htfab/breakout-tt08-cob/README.md

# Tiny Tapeout COB pcb (TT08)

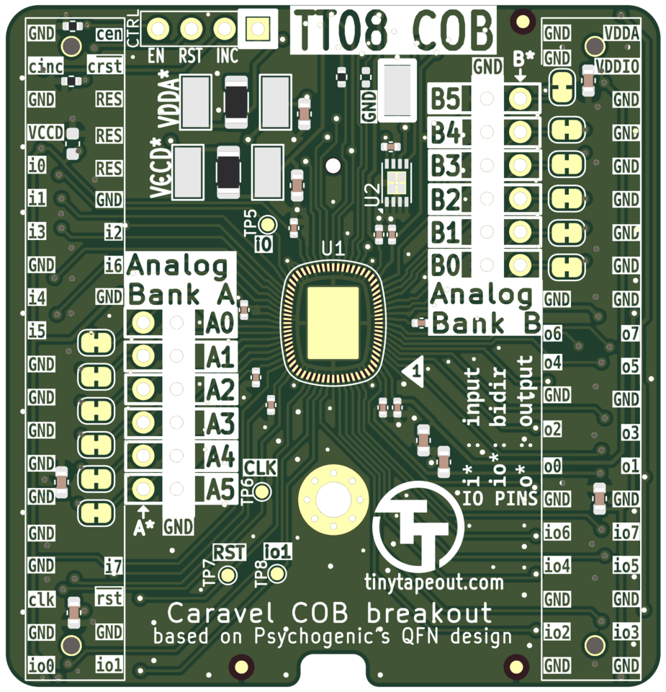
[picture p1: images/top.png]
&emsp;
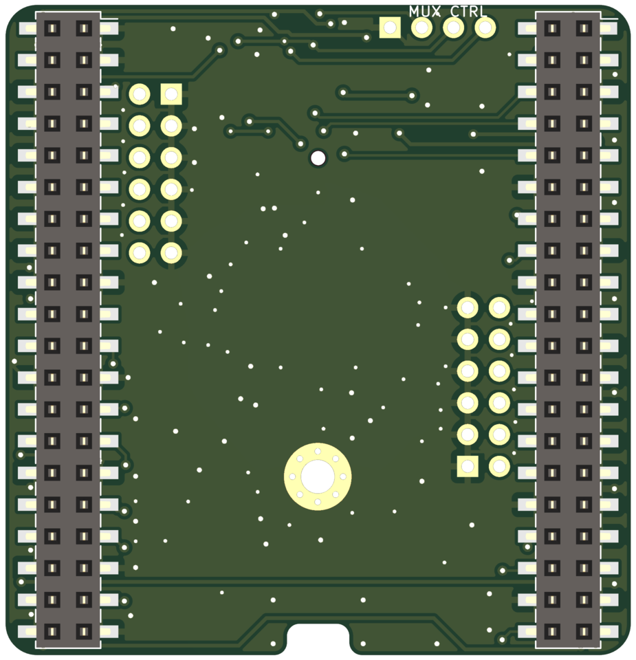
[picture p2: images/bottom.png]
