htfab/breakout-tt08-cob/breakout-tt08-cob.kicad_sch

## KiCad design breakout-tt08-cob.kicad_sch (2025-10-29)

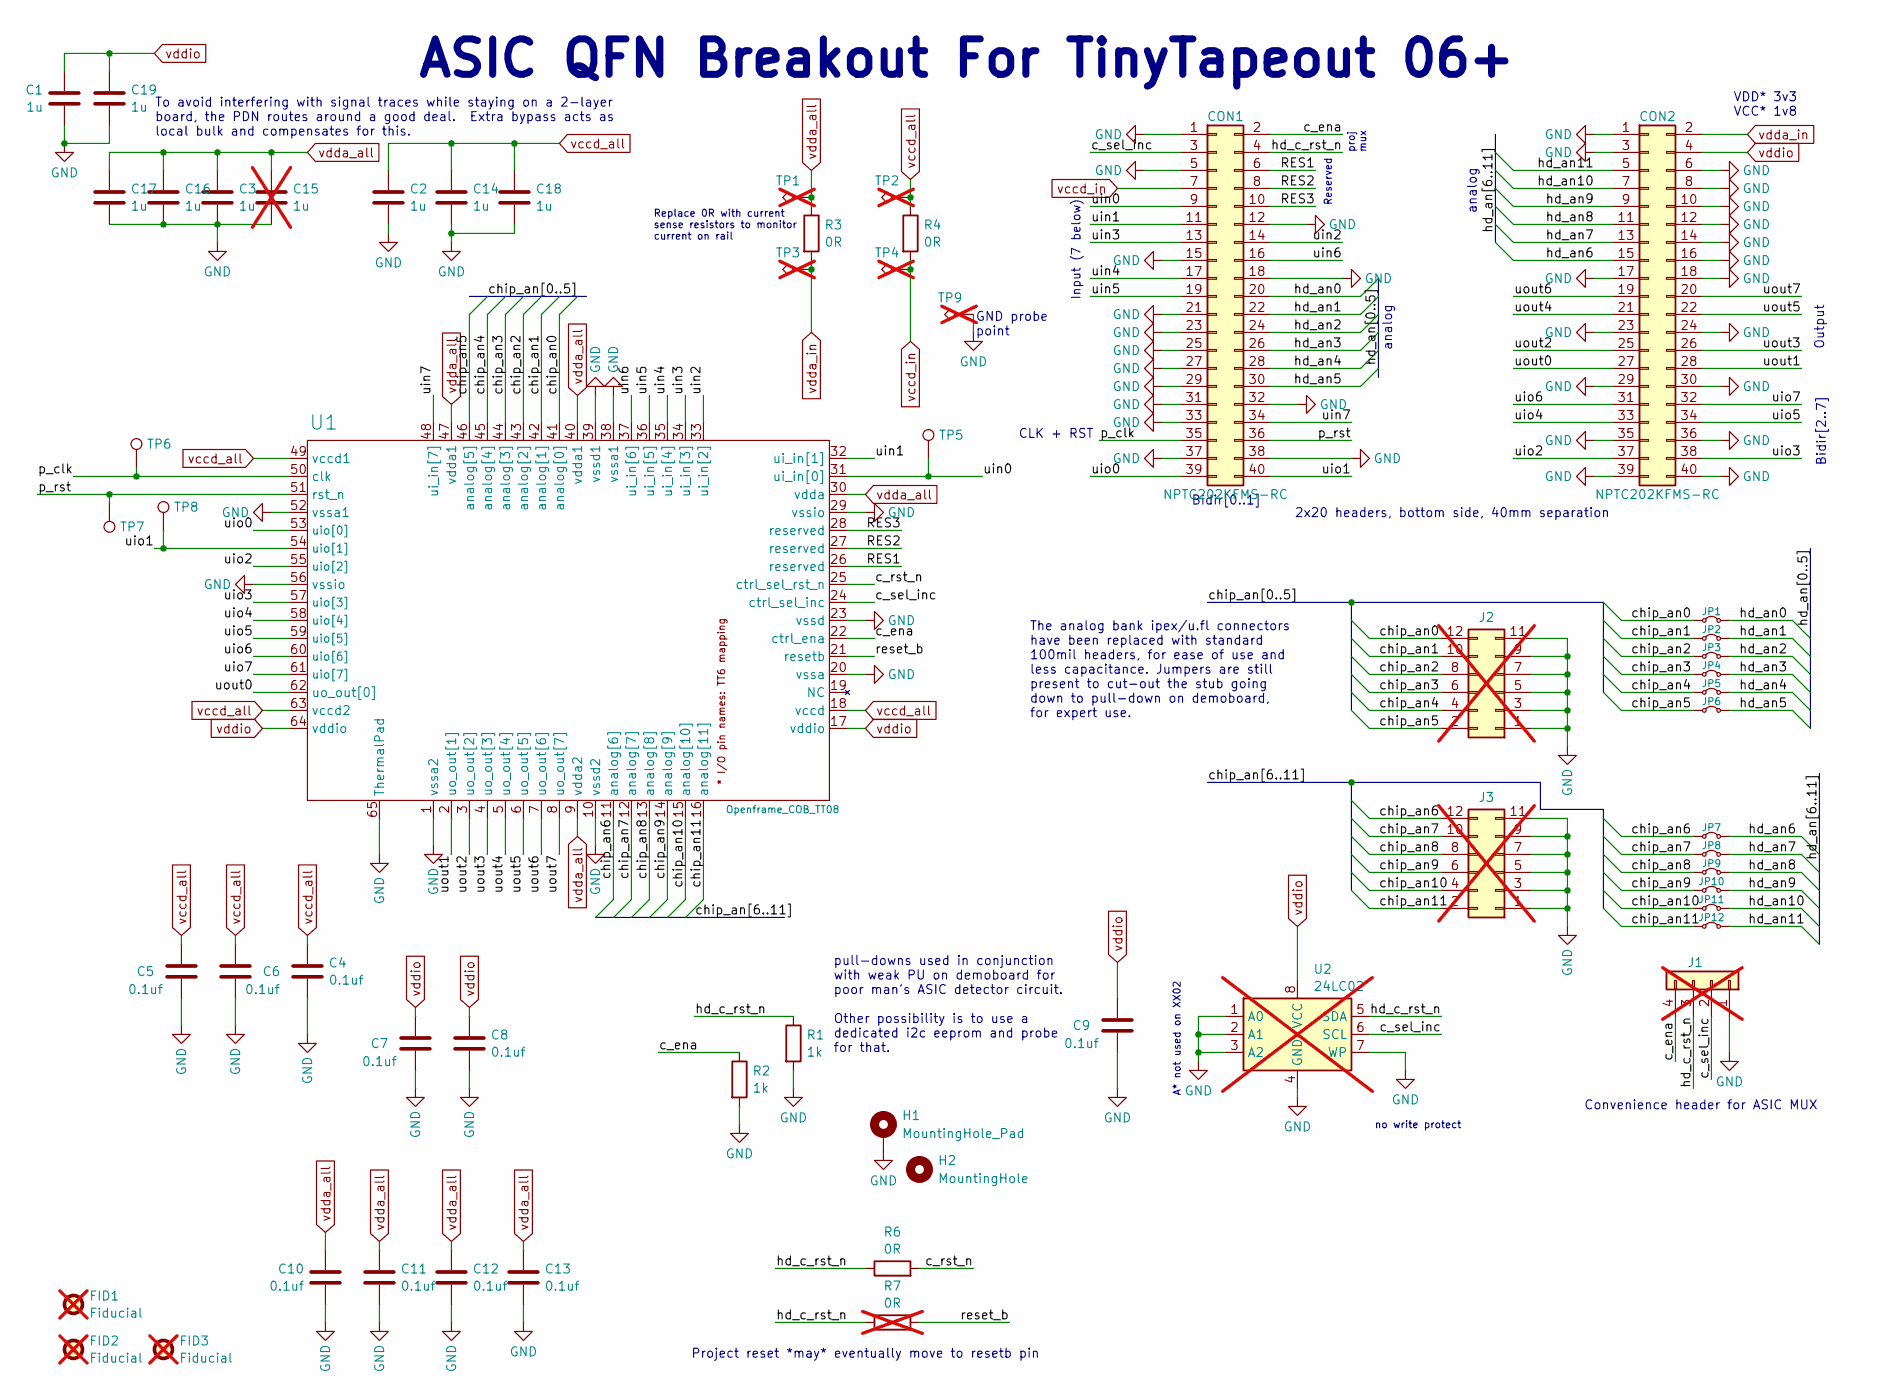
[picture p3: schematic breakout-tt08-cob.kicad_sch]

Parts:
C1, C2, C3, C14, C16, C17, C18, C19: C_1u_0603_50V; C_0603_1608Metric; MPN GRT188R61H105KE13D; DigikeyPN 490-12330-1-ND
C4, C5, C6, C7, C8, C9, C10, C11, C12, C13: 0.1uf; C_0402_1005Metric; MPN CL05A104KA5NNNC; LCSC C100072
C15: C_1u_0603_50V; C_0603_1608Metric; MPN GRT188R61H105KE13D; DigikeyPN 490-12330-1-ND; not fitted
CON1, CON2: NPTC202KFMS-RC; FH-00148_PinSocket_2x20_P2.54mm; MPN NPTC202KFMS-RC; DigikeyPN S5690-ND
FID1, FID2, FID3: Fiducial; Fiducial_1mm_Mask2mm; not fitted
H1: MountingHole_Pad; MountingHole_2.7mm_M2.5_Pad_Via
H2: MountingHole; ToolingHole_1.152mm
J1: Conn_01x04; PinHeader_1x04_P2.54mm_Vertical; not fitted
J2, J3: Conn_02x06_Odd_Even; PinHeader_2x06_P2.54mm_Vertical; not fitted
JP1, JP2, JP3, JP4, JP5, JP6, JP7, JP8, JP9, JP10, JP11, JP12: Jumper_2_Small_Bridged; SolderJumper-2_P1.3mm_Bridged_RoundedPad1.0x1.5mmEasyCut
R1, R2: 1k; R_0402_1005Metric; LCSC C202394
R3, R4: 0R; R_1206_3216Metric; MPN RC1206FR-130RL; DigikeyPN 13-RC1206FR-130RLCT-ND
R6: 0R; R_0402_1005Metric; MPN RC0402JR-070RL; DigikeyPN 311-0.0JRCT-ND
R7: 0R; R_0402_1005Metric; MPN RC0402JR-070RL; DigikeyPN 311-0.0JRCT-ND; not fitted
TP1, TP2, TP3, TP4, TP9: TestPoint_Alt; TestPoint_Keystone_5019_Minature; MPN 5019; DigikeyPN 36-5019CT-ND; not fitted
TP5, TP6, TP7, TP8: TestPoint; TestPoint_Pad_D1.0mm
U1: Openframe_COB_TT08; caravel_cob_100_105; MPN TT_ASIC
U2: 24LC02; DFN-8-1EP_3x2mm_P0.5mm_EP1.75x1.45mm; MPN 24LC02BT-I/MC; DigikeyPN 24LC02BT-I/MCCT-ND; not fitted

Connections:
GND: C1.2, C2.2, C3.2, C4.1, C5.1, C6.2, C7.1, C8.1, C9.1, C10.2, C11.2, C12.2, C13.1, C14.2, C15.2, C16.2, C17.2, C18.2, C19.2, CON1.1, CON1.5, CON1.12, CON1.15, CON1.18, CON1.21, CON1.23, CON1.25, CON1.27, CON1.29, CON1.31, CON1.32, CON1.33, CON1.37, CON1.38, CON2.1, CON2.3, CON2.6, CON2.8, CON2.10, CON2.12, CON2.14, CON2.16, CON2.17, CON2.18, CON2.23, CON2.24, CON2.29, CON2.30, CON2.35, CON2.36, CON2.39, CON2.40, H1.1, J1.1, J2.1, J2.3, J2.5, J2.7, J2.9, J2.11, J3.1, J3.3, J3.5, J3.7, J3.9, J3.11, R1.2, R2.2, TP9.1, U1.1 (vssa2), U1.10 (vssd2), U1.20 (vssa), U1.23 (vssd), U1.29 (vssio), U1.38 (vssa1), U1.39 (vssd1), U1.52 (vssa1), U1.56 (vssio), U1.65 (ThermalPad), U2.1 (A0), U2.2 (A1), U2.3 (A2), U2.4 (GND), U2.7 (WP)
RES1: CON1.6, U1.26 (reserved)
RES2: CON1.8, U1.27 (reserved)
RES3: CON1.10, U1.28 (reserved)
c_ena: CON1.2, J1.4, R2.1, U1.22 (ctrl_ena)
c_rst_n: R6.2, U1.25 (ctrl_sel_rst_n)
c_sel_inc: CON1.3, J1.2, U1.24 (ctrl_sel_inc), U2.6 (SCL)
chip_an0: J2.12, JP1.1 (A), U1.41 (analog[0])
chip_an1: J2.10, JP2.1 (A), U1.42 (analog[1])
chip_an2: J2.8, JP3.1 (A), U1.43 (analog[2])
chip_an3: J2.6, JP4.1 (A), U1.44 (analog[3])
chip_an4: J2.4, JP5.1 (A), U1.45 (analog[4])
chip_an5: J2.2, JP6.1 (A), U1.46 (analog[5])
chip_an6: J3.12, JP7.1 (A), U1.11 (analog[6])
chip_an7: J3.10, JP8.1 (A), U1.12 (analog[7])
chip_an8: J3.8, JP9.1 (A), U1.13 (analog[8])
chip_an9: J3.6, JP10.1 (A), U1.14 (analog[9])
chip_an10: J3.4, JP11.1 (A), U1.15 (analog[10])
chip_an11: J3.2, JP12.1 (A), U1.16 (analog[11])
hd_an0: CON1.20, JP1.2 (B)
hd_an1: CON1.22, JP2.2 (B)
hd_an2: CON1.24, JP3.2 (B)
hd_an3: CON1.26, JP4.2 (B)
hd_an4: CON1.28, JP5.2 (B)
hd_an5: CON1.30, JP6.2 (B)
hd_an6: CON2.15, JP7.2 (B)
hd_an7: CON2.13, JP8.2 (B)
hd_an8: CON2.11, JP9.2 (B)
hd_an9: CON2.9, JP10.2 (B)
hd_an10: CON2.7, JP11.2 (B)
hd_an11: CON2.5, JP12.2 (B)
hd_c_rst_n: CON1.4, J1.3, R1.1, R6.1, R7.1, U2.5 (SDA)
p_clk: CON1.35, TP6.1, U1.50 (clk)
p_rst: CON1.36, TP7.1, U1.51 (rst_n)
reset_b: R7.2, U1.21 (resetb)
uin0: CON1.9, TP5.1, U1.31 (ui_in[0])
uin1: CON1.11, U1.32 (ui_in[1])
uin2: CON1.14, U1.33 (ui_in[2])
uin3: CON1.13, U1.34 (ui_in[3])
uin4: CON1.17, U1.35 (ui_in[4])
uin5: CON1.19, U1.36 (ui_in[5])
uin6: CON1.16, U1.37 (ui_in[6])
uin7: CON1.34, U1.48 (ui_in[7])
uio0: CON1.39, U1.53 (uio[0])
uio1: CON1.40, TP8.1, U1.54 (uio[1])
uio2: CON2.37, U1.55 (uio[2])
uio3: CON2.38, U1.57 (uio[3])
uio4: CON2.33, U1.58 (uio[4])
uio5: CON2.34, U1.59 (uio[5])
uio6: CON2.31, U1.60 (uio[6])
uio7: CON2.32, U1.61 (uio[7])
uout0: CON2.27, U1.62 (uo_out[0])
uout1: CON2.28, U1.2 (uo_out[1])
uout2: CON2.25, U1.3 (uo_out[2])
uout3: CON2.26, U1.4 (uo_out[3])
uout4: CON2.21, U1.5 (uo_out[4])
uout5: CON2.22, U1.6 (uo_out[5])
uout6: CON2.19, U1.7 (uo_out[6])
uout7: CON2.20, U1.8 (uo_out[7])
vccd_all: C2.1, C4.2, C5.2, C6.1, C14.1, C18.1, R4.1, TP2.1, U1.18 (vccd), U1.49 (vccd1), U1.63 (vccd2)
vccd_in: CON1.7, R4.2, TP4.1
vdda_all: C3.1, C10.1, C11.1, C12.1, C13.2, C15.1, C16.1, C17.1, R3.1, TP1.1, U1.9 (vdda2), U1.30 (vdda), U1.40 (vdda1), U1.47 (vdda1)
vdda_in: CON2.2, R3.2, TP3.1
vddio: C1.1, C7.2, C8.2, C9.2, C19.1, CON2.4, U1.17 (vddio), U1.64 (vddio), U2.8 (VCC)

Notes on the sheet:
CLK + RST
Convenience header for ASIC MUX
Reserved
ASIC QFN Breakout For TinyTapeout 06+
VDD* 3v3 VCC* 1v8
A* not used on XX02
2x20 headers, bottom side, 40mm separation
no write protect
pull-downs used in conjunction with weak PU on demoboard for poor man's ASIC detector circuit. Other possibility is to use a dedicated i2c eeprom and probe for that.
GND probe point
proj mux
analog
Bidir[0..1]
Input (7 below)
To avoid interfering with signal traces while staying on a 2-layer board, the PDN routes around a good deal. Extra bypass acts as local bulk and compensates for this.
Replace 0R with current sense resistors to monitor current on rail
Project reset *may* eventually move to resetb pin
The analog bank ipex/u.fl connectors have been replaced with standard 100mil headers, for ease of use and less capacitance. Jumpers are still present to cut-out the stub going down to pull-down on demoboard, for expert use.
Bidir[2..7]
Output
