htfab/breakout-tt08-cob/(commit log)

2025-10-28 add files to version control
    [breakout-tt08-cob.kicad_pcb, breakout-tt08-cob.kicad_sch]
2025-10-28 render pcb without DNP components
2025-10-28 minor silkscreen fixes
    [breakout-tt08-cob.kicad_pcb]
2025-10-28 update cob footprint
    [breakout-tt08-cob.kicad_pcb]
2025-10-29 update metadata and production export settings
    [breakout-tt08-cob.kicad_pcb, breakout-tt08-cob.kicad_sch]
