htfab/breakout-tt08-cob/(notices)

Notices in the files:
breakout-tt08-cob.kicad_sch:
(C) 2024-2025 Pat Deegan
